phamminhhai8x/AutoFindTarget/README.md

# AutoFindTarget

#Team
* Bui Tuan Anh				11ES
* Nguyen Hoang Anh Khoa		11ES
* Nguyen Truong Trong Nhan		11ES
* Tran Ngoc Quang				11ES
* Nguyen Tin					11ES

#Supervisor
* Pham Minh Hai				FPT
* Ho Viet Nhu Dao			FPT
* Phan Tuan Hiep		  FPT
