phamminhhai8x/AutoFindTarget/Documents/Obstalces_Avoiding.docx

Name: Obstacles_Avoiding

Function: Robot avoids obstacles

Input: dis: Distance between Robot and Obtacle

vel1: The original velocity of Robot

Output: svVal: Turning angle

vel2: The velocity after turning line

tim1: Time needs to turn line

tim2: Time needs to avoid obstacles
