phamminhhai8x/AutoFindTarget/Documents/So_sánh_mô_hình_và_xe_thật.docx

In project:

- Car (40cm x 18cm).
- Street (2 lines- the width: 60cm).
- The speed of Car (40 km/h).

In reality:

- According to Toyota Camry lengthx widthx height: 4825x 1820x 1480 (mm)

http://i-view.vn/i-view-news/44-tinchuyenganhkientrucnoithat/57-kich-thuoc-xe-oto-thong-dung

- According to table 3- Technical table decentralized functional motorways of the road and design flow and table 6- Minimum width elements on the cross for plain and hilly terrain.
- Car will run on a street which is at IV level.
- The speed of car is about 60 km/h.
- The width of a line in a street (2 lines): 3.5m.

http://cucqlxd.gov.vn/media/documents/tcvn_4054_2005.pdf

Both the project and reality, the car run on a street which has a lot of obtacles such as human, other cars, motorbike, bike and across corners.
