phamminhhai8x/AutoFindTarget/Documents/Góc_quay.docx

Vận tốc chênh lệch giữa A và B:

Vc=x/t

Thời gian 2 xe sẽ va chạm:

t=(s-x)/(x/t)

Nếu vật cản đứng yên Vc bằng VA
