phamminhhai8x/AutoFindTarget/(list of files, cad)

Other CAD files:
Diagram/bang ke 2D.skp
Diagram/bang ke 3D.skp
Diagram/sensor.skp
