phamminhhai8x/AutoFindTarget/Source code/MCU02/myOS_hard_init.cpp

// 
// 
// 
#include "myOS_hard_init.h"

void variable_init(){

}

void IO_init(){
	//DDRD |= _BV(2); 
	//DDRD |= _BV(4); 
	//DDRD &= ~_BV(3); 
	//DDRD &= ~_BV(5); 
	pinMode(7, OUTPUT);
	pinMode(8, OUTPUT);
	pinMode(9, OUTPUT);
	pinMode(A0, OUTPUT);

	pinMode(5, INPUT);
	pinMode(7, OUTPUT);
}

#if 1
void timer_init(){	
  TCCR2A = 0;
  TCCR2B = 0;
  TCNT2  = 0;
  
  OCR2A = 255;
  // turn on CTC mode
  TCCR2A |= (1 << WGM21);
  // Set CS21 bit for 64 prescaler
  TCCR2B |= (1 << CS22);   
  // enable timer compare interrupt 
  TIMSK2 |= (1 << OCIE2A);
}
#endif

void hardware_init() {
	IO_init();
	timer_init();
}
